pnsn/mcsoh/images/2-IMG_2275.JPG

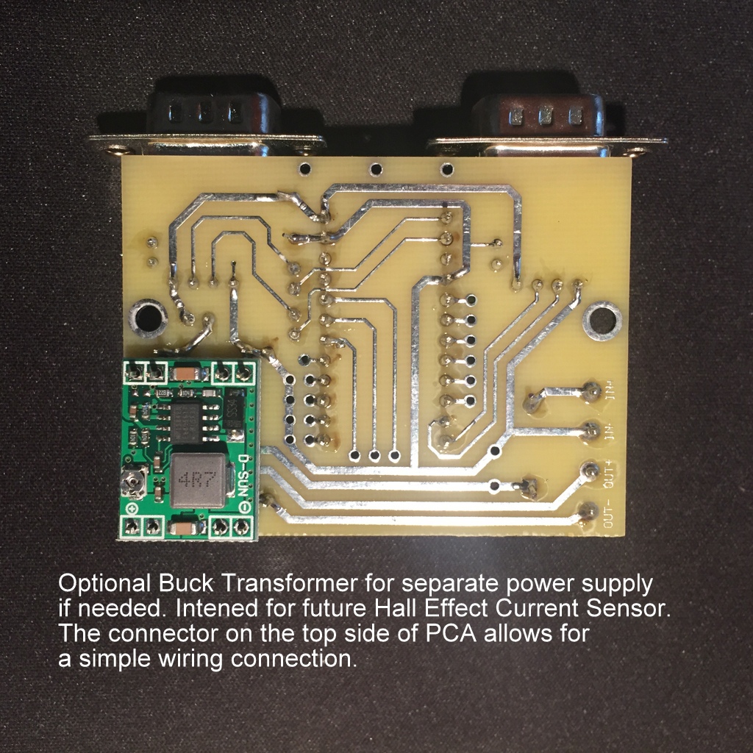
images/2-IMG_2275.JPG
