pnsn/mcsoh/images/1-IMG_2274.JPG

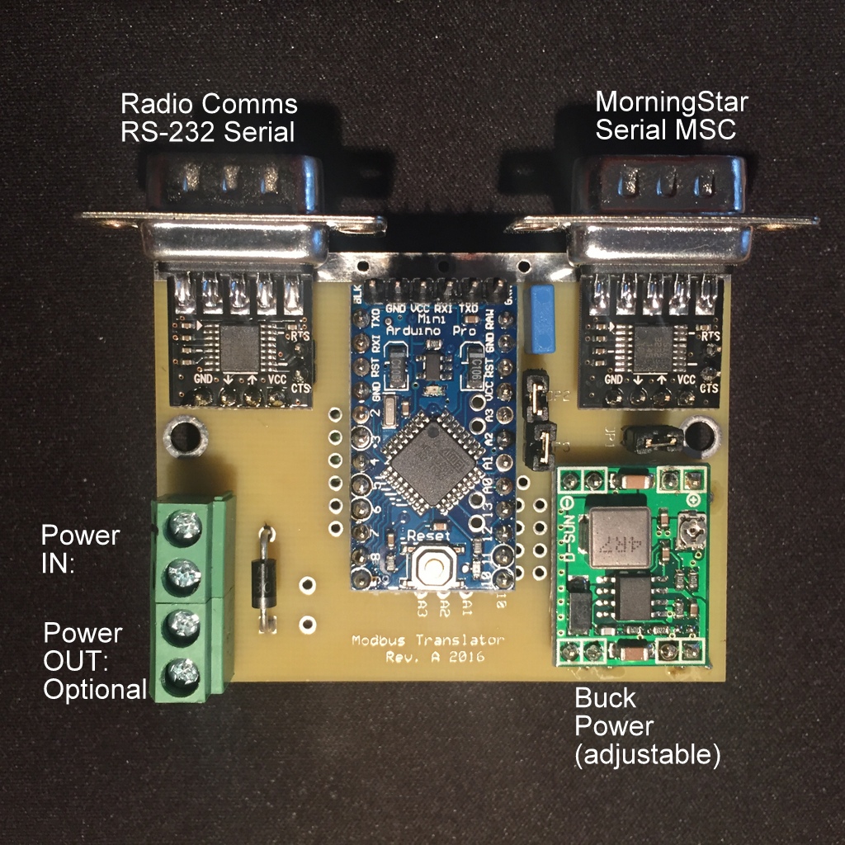
images/1-IMG_2274.JPG
