pnsn/mcsoh/tools/README.md

#tools directory: place to keep and utilities or tools for reflashing, testing, fixing etc...
i.e. AVRDude tool for reflashing Arduino microcontrollers.
