pnsn/mcsoh/docs/Params2.docx

The company

MODBUS Translator

Message Specification

Marc Biundo

| SunSaver MPPT Message Layout
ModBus Logical Addr | Item name | Item description | Units | Scaling / Range / Example Data
- | Message ID | $PMPPTDAT | - | -
- | FW Version | Firmware Version | | 1.0.0
9 | Adc_vb_f | Battery voltage, filtered (τ ≈ 1s) | V | n·100·2⁻¹⁵
10 | Adc_va_f | Array voltage, filtered (τ ≈ 1s) | V | n·100·2⁻¹⁵
11 | Adc_vl_f | Load voltage, filtered (τ ≈ 1s) | V | n·100·2⁻¹⁵
12 | Adc_ic_f | Charging current, filtered (τ ≈ 1s) | A | n·79.16·2⁻¹⁵
13 | Adc_il_f | Load current, filtered (τ ≈ 1s) | A | n·79.16·2⁻¹⁵
14 | T_hs | Heatsink temperature | ºC | -127 to+127
15 | T_batt | Battery temperature (Either ambient or RTS if connected) | ºC | -127 to+127
16 | T_amb | Ambient temperature | ºC | -127 to+127
17 | T_rts | Remote battery temperature sensor (0x80 if not connected) | ºC | -127 to+127
18 | charge_state | Charge state - | -
19 | array_fault | Array fault bit field - | -
20 | Vb_f | Battery voltage, slow filter (τ ≈ 25s) | V | n·100·2⁻¹⁵
21 | Vb_ref | Battery regulator reference voltage | V | n·96.667·2⁻¹⁵
22 | Ahc_r_HI | Ah charge resettable, HI word | Ah | n·0.1
23 | Ahc_r_LO | Ah charge resettable, LO word - | -
24 | Ahc_t_HI | Ah charge total, HI word | Ah | n·0.1
25 | Ahc_t_LO | Ah charge total, LO word - | -
26 | kWhc | KWh charge (resettable?) | kWh | n·0.1
27 | load_state | Load state - | -
28 | load_fault | Load fault bit field - | -
29 | V_lvd | load current compensated LVD voltage | V | n·100·2⁻¹⁵
30 | Ahl_r_HI | Ah load resettable, HI word | Ah | n·0.1
31 | Ahl_r_LO | Ah load resettable, LO word - | -
32 | Ahl_t_HI | Ah load total, HI word | Ah | n·0.1
33 | Ahl_t_LO | Ah load total, LO word - | -
34 | hourmeter_HI | hour meter, HI word | h | 0 to (2²⁴-1)
35 | hourmeter_LO | hour meter, LO word - | -
36 | alarm_HI | alarm bit field – HI word - | -
37 | alarm_LO | alarm bit field – LO word - | -
38 | dip_switch | dip switch settings at power on switch[1..8] in bits[0..7]- | -
39 | led_state | SOC LED state - | -
40 | Power_out | Charge output power | W | n·989.5·2⁻¹⁶
41 | Sweep_Vmp | Array Vmp found during sweep | V | n·100·2⁻¹⁵
42 | Sweep_Pmax | Arrap Pmax(output) found during sweep | W | n·989.5·2⁻¹⁶
43 | Sweep_Voc | Array Voc found during sweep | V | n·100·2⁻¹⁵
44 | Vb_min_daily | Vb minimum voltage – daily | V | n·100·2⁻¹⁵
45 | Vb_max_daily | Vb maximum voltage – daily | V | n·100·2⁻¹⁵
46 | Ahc_daily | Ah charge - daily | Ah | n·0.1
47 | Ahl_daily | Ah load - daily | Ah | n·0.1
48 | array_fault_daily | Array fault bit field - daily - | -
49 | load_fault_daily | Load fault bit field - daily - | -
50 | alarm_HI_daily | alarm bit field – daily, HI word - | -
51 | alarm_LO_daily | alarm bit field – daily, LO word - | -
52 | vb_min | minimum battery voltage | V | n·100·2⁻¹⁵
53 | vb_max | maximum battery voltage | V | n·100·2⁻¹⁵
- | Checksum | *hh | - | 00 - FF
- | EOM | <CR><LF> (End of message termination) | -

Modeled after NEMA 0183 specification. A simple ASCII serial communication protocol that define how data are transmitted in a “sentence” from the ‘talker’ to the ‘listener’.

Protocol rules:

- Each message's starting character is a dollar sign.
- The next eight characters identify the talker (5 characters) and the type of message (3 characters).
- All data fields that follow are comma-delimited.
- Where data is unavailable, the corresponding field remains blank (it contains no character before the next delimiter.
- The first character that immediately follows the last data field character is an asterisk, but it is only included if a checksum is supplied.
- The asterisk is immediately followed by a checksum represented as a two-digit hexadecimal number. The checksum is the bitwise exclusive OR of ASCII codes of all characters between the $ and *. According to the official specification, the checksum is optional for most data sentences, but is compulsory for RMA, RMB, and RMC (among others).
- <CR><LF> ends the message.

Each item adheres to Modbus rules; that is, they are 16-bit raw values that need to be scaled as indicated in the above table.

SunSaver MPPT Logged Data Layout
Item name | Item description | Units | Scaling / Range / Example Data
Message ID | $PMPPTLOG | - | -
Hourmeter | 24 bit value ‘hour meter’ timestamp | h | 0 to (2²⁴-1)
Alarm_daily | 24 bit Alarm bit field – daily | - | -
Vb_min_daily | Vb minimum voltage – daily | V | n·100·2⁻¹⁵
Vb_max_daily | Vb maximum voltage - daily | V | n·100·2⁻¹⁵
Ahc_daily | Ah charge - daily | Ah | n·0.1
Ahl_daily | Ah load - daily | Ah | n·0.1
Array_fault_daily | Array fault bit field – daily | - | -
Load_fault_daily | Load fault bit field – daily | - | -
Va_max_daily | Va maximum voltage – daily | V | n·100·2⁻¹⁵
Time_ab_daily | Time in absorption - daily | min | -
Time_eq_daily | Time in equalize - daily | min | -
Time_fl_daily | Time in float – daily | min | -
- | Reserved | - | -
- | Reserved | - | -
- | Reserved | - | -
Checksum | *hh | - | 00 - FF
EOM | <CR><LF> (End of message termination) | -

Logged Data

The SS-MPPT stores approximately 32 days of data. This data is stored in a circular buffer where the oldest data is over-written by the newest data. The log data must be requested and sorted into correct order before the data will be useful.

- The logged data is mapped from 0x8000-0x81FF (1kB)
- The data consists of up to 32 blocks of data. (One block is generally one day w/ some exceptions)
- Each block is 32bytes (16 modbus variables)
- It is written in a circular buffer format. All blocks must be read and then put in linear order via the hourmeter field. Ignore blocks w/ hourmeters of 0x000000 or 0xFFFFFF. The largest hourmeter block is the most recent.

Data is stored in big endian format.

struct { Uint24 hourmeter;

Uint24 alarm_daily;

Uint16 Vb_min_daily;

Uint16 Vb_max_daily;

Uint16 Ahc_daily;

Uint16 Ahl_daily;

Uint16 array_fault_daily;

Uint16 load_fault_daily;

Uint16 Va_max_daily;

Uint16 time_ab_daily; v0.7 code and later

Uint16 time_eq_daily; v0.7 code and later

Uint16 time_fl_daily; v0.7 code and later

Uint16 reserved[3];

}

Data Retrieval Commands

In order to make the retrieval of data controllable there are three methods for the translator to send messages.

1. ‘t’ - Periodic method. Message string will be sent at a timed interval (every 5 seconds for instance).
2. ‘r’ - Command based method. Send messages upon command from the receiver. Periodic method disabled.
3. ‘l’ - Command based Logged Data method. Shuts down status messages and sends one log entry per command. The status messages are disable until either of the above commands are sent.

The logged data is retrieved using the ‘l’ (logged) command. Each command cause one entry of the MPPT log circular buffer to be read and sent out. Each entry has a ‘hourmeter’ time stamp. After all the entries have been retrieved (32) they need to be sorted by the ‘hourmeter’ field. This is also the way you can tell if all the entries have been received. The status messages are disabled so as not to mix up the receiver on what data is being received.

After getting the logged data, the status messages can be turn back on by either sending the ‘t’ command causing the messages to be sent on a time interval or the ‘r’ command that will get one status message only.
