pnsn/mcsoh/Battery Spec Sheets/AirCells-2 AS10-2_en.pdf

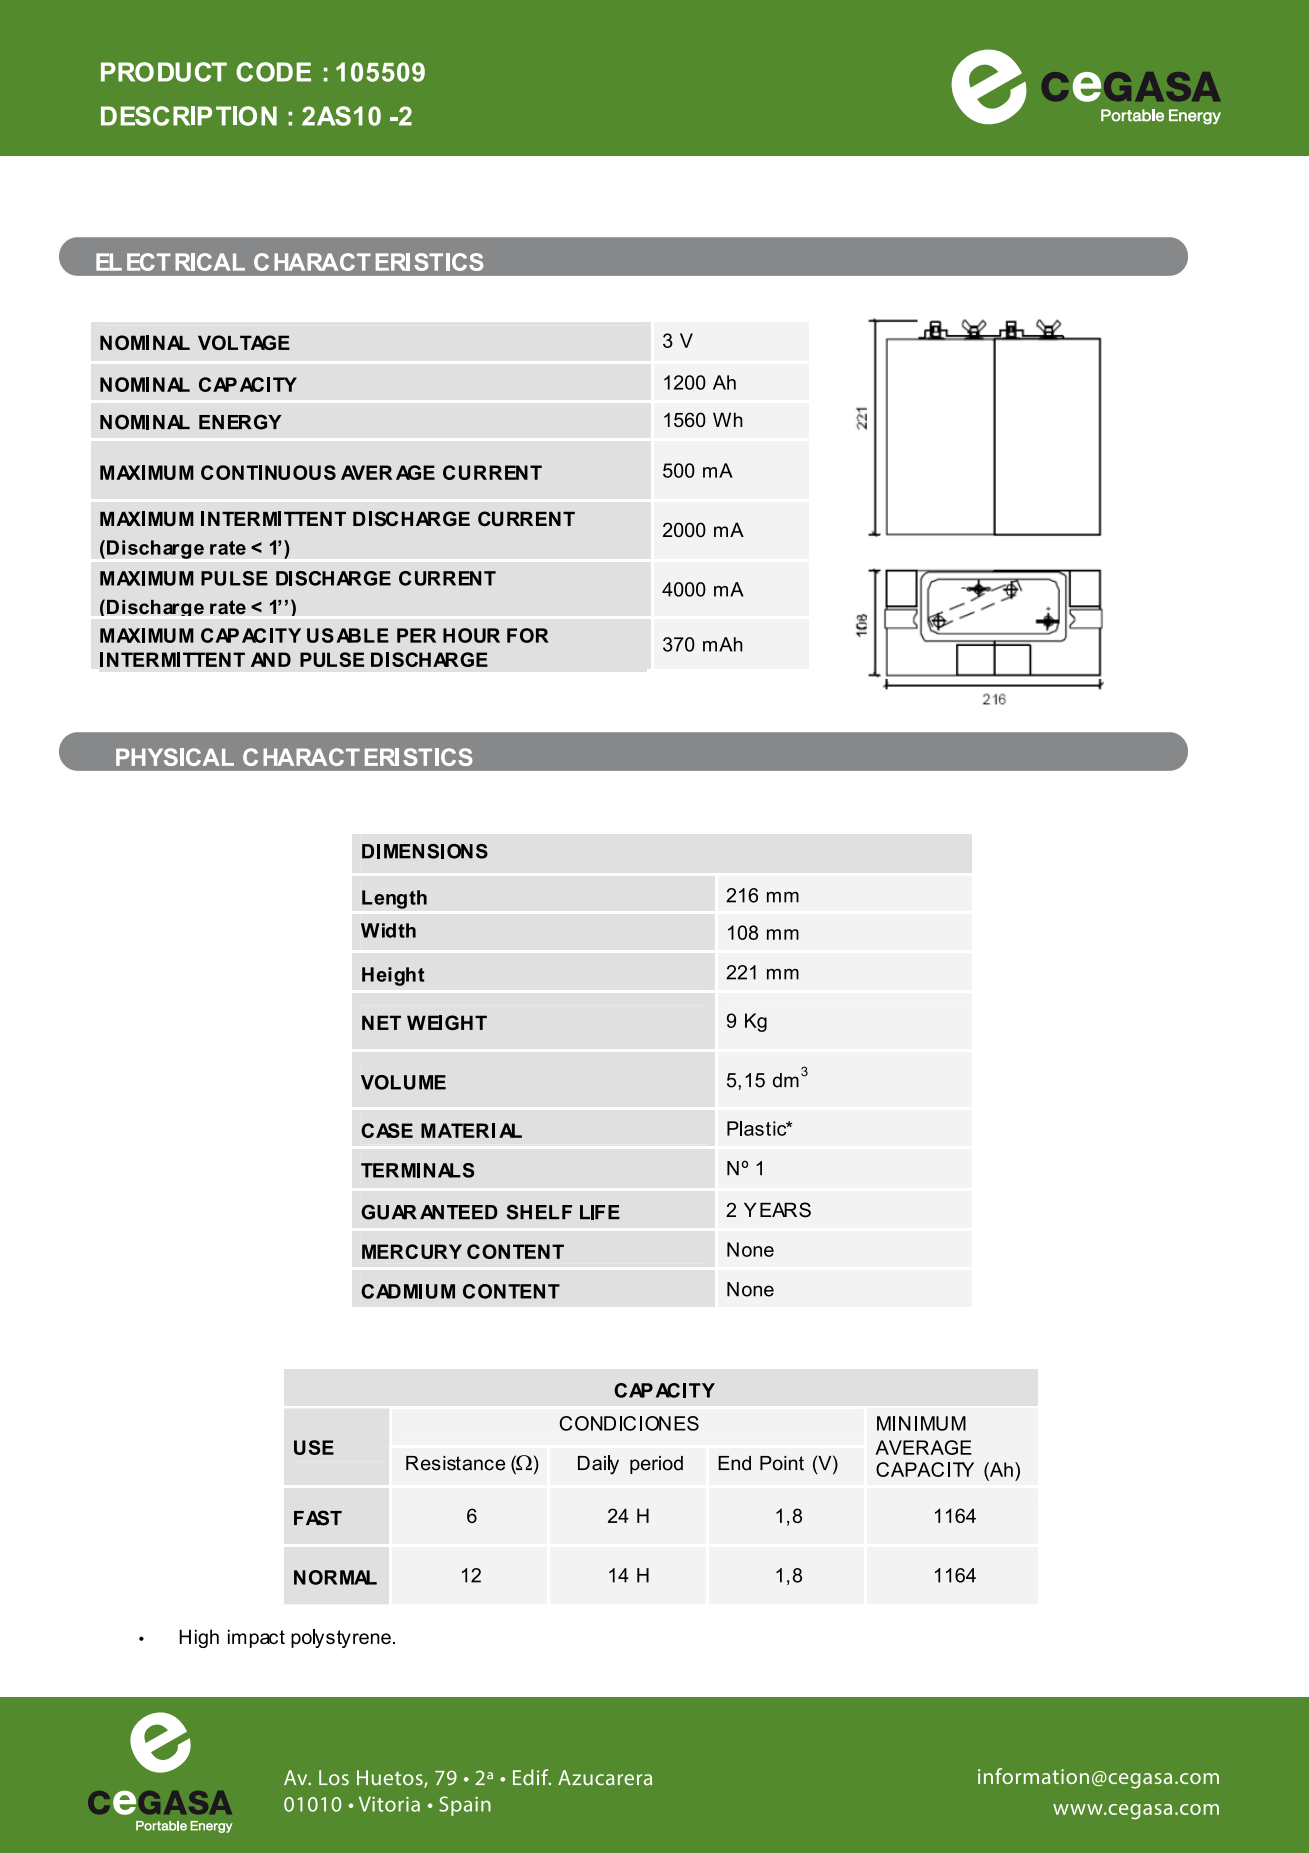
[picture p7: page 1]

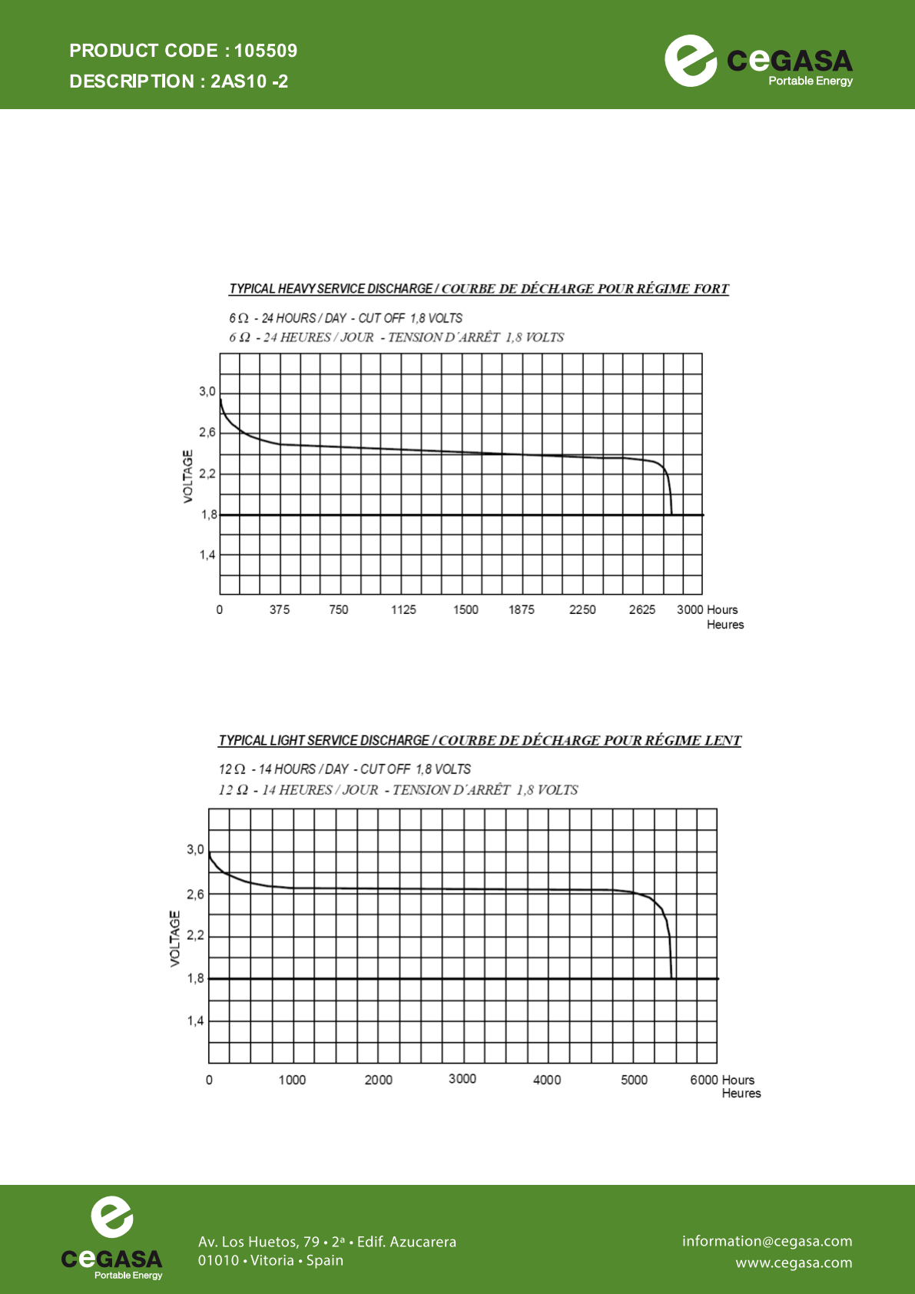
[picture p8: page 2]
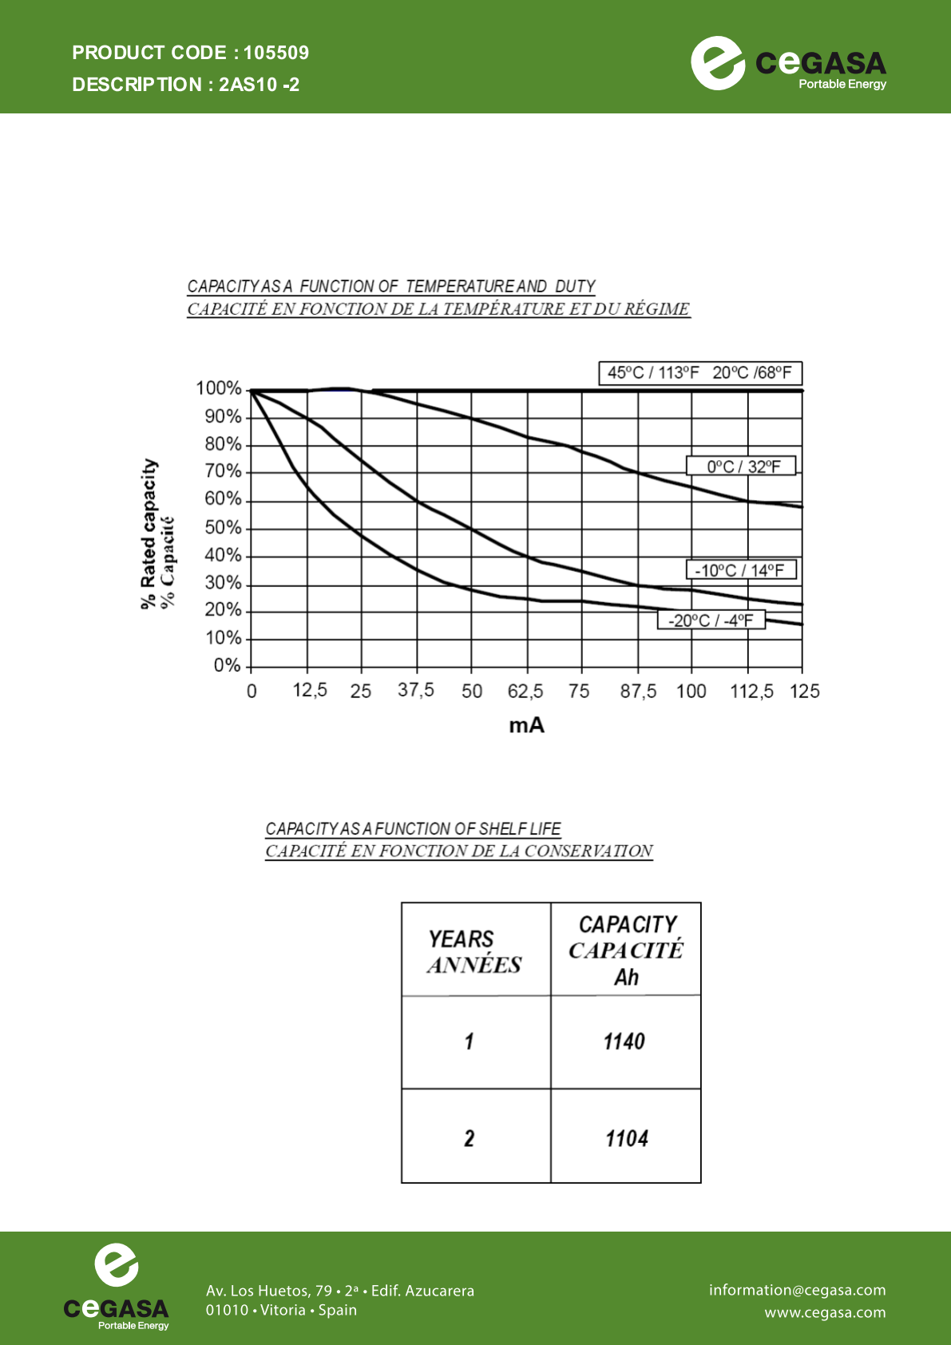
[picture p9: page 3]
