pnsn/mcsoh/Battery Spec Sheets/Battery LA AGM DURA12-35C.pdf

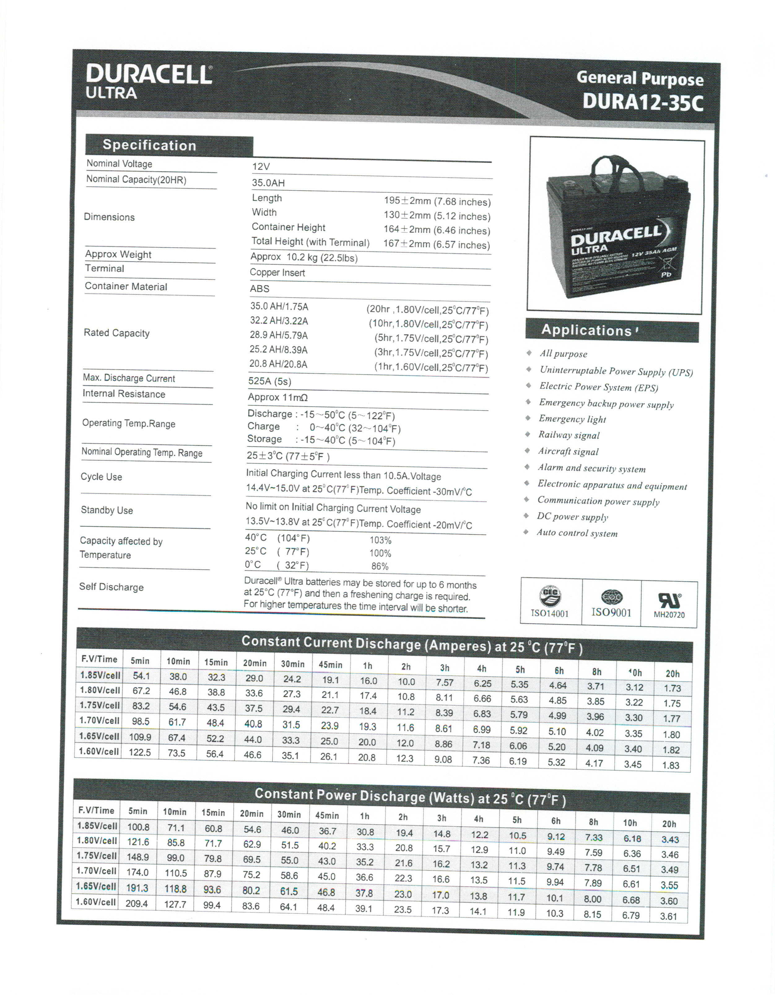
[picture p10: page 1]
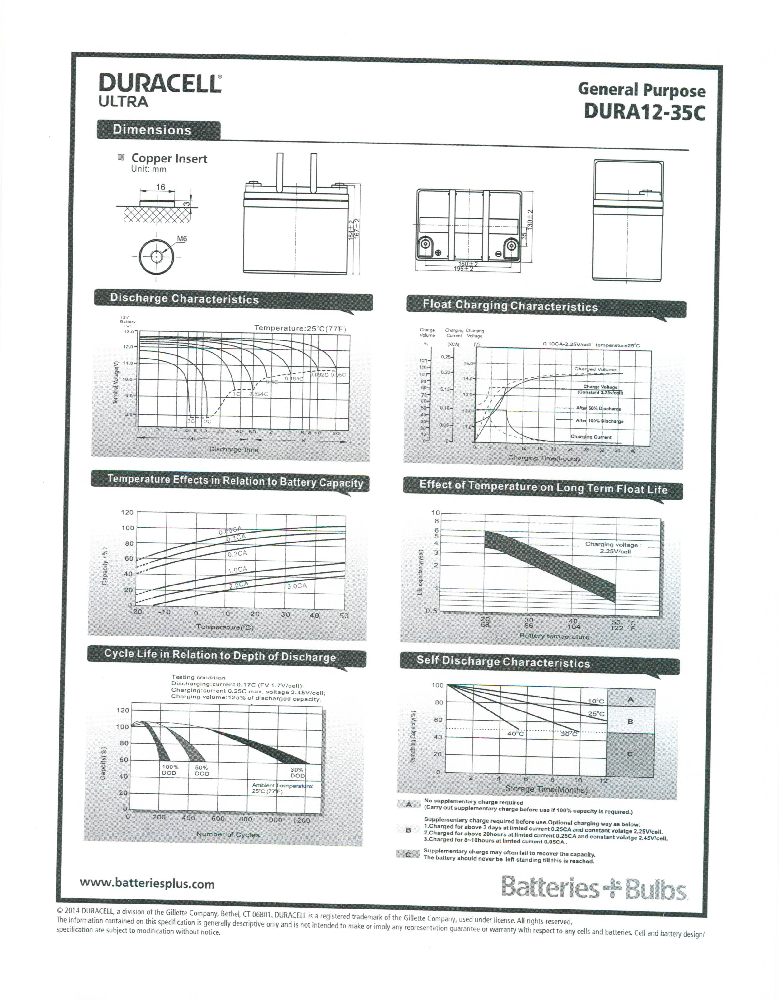
[picture p11: page 2]
