pnsn/mcsoh/ExpressPCB/Modbus Translator MiniBrd RevEXP1.bmp

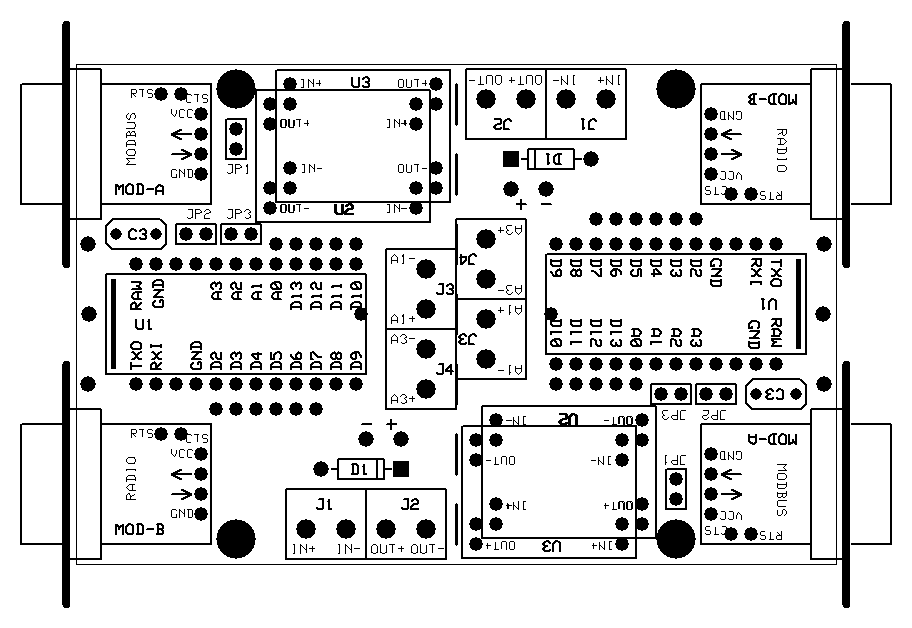
ExpressPCB/Modbus Translator MiniBrd RevEXP1.bmp
