pnsn/mcsoh/images/3-IMG_2276.JPG

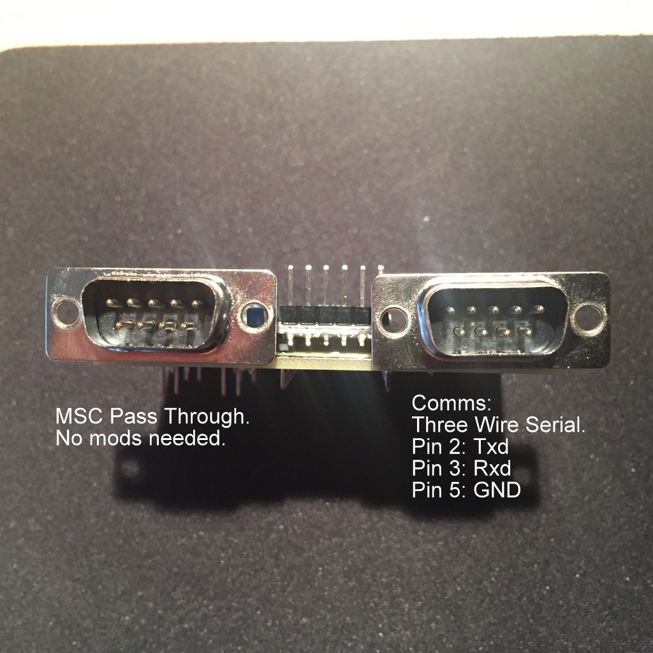
images/3-IMG_2276.JPG
