pnsn/mcsoh/images/4-IMG_2277.JPG

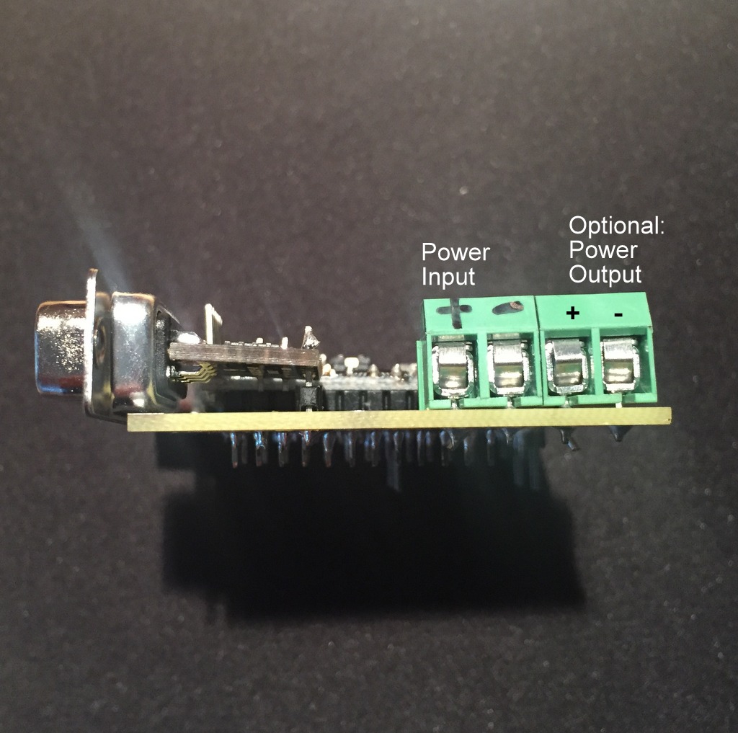
images/4-IMG_2277.JPG
