pnsn/mcsoh/images/5-IMG_2279.JPG

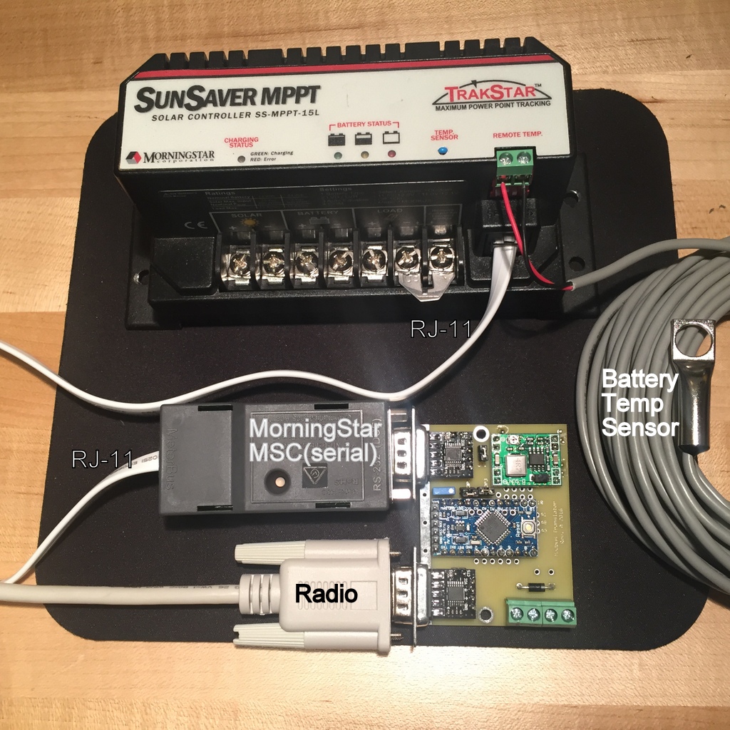
images/5-IMG_2279.JPG
