pnsn/mcsoh/images/6-IMG_2280.JPG

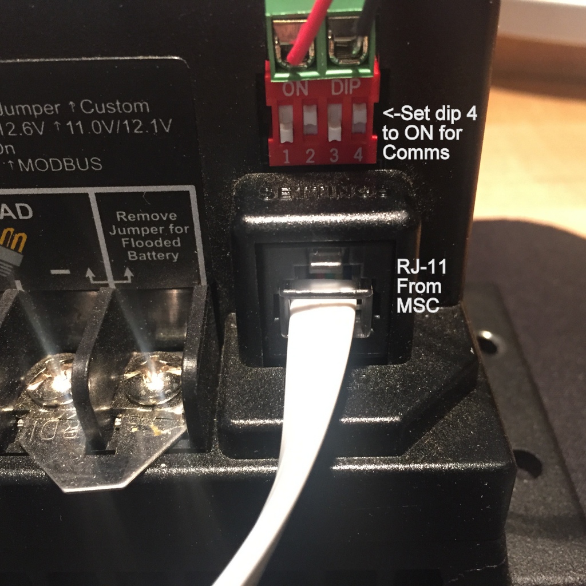
images/6-IMG_2280.JPG
