pnsn/mcsoh/images/7-IMG_2281.JPG

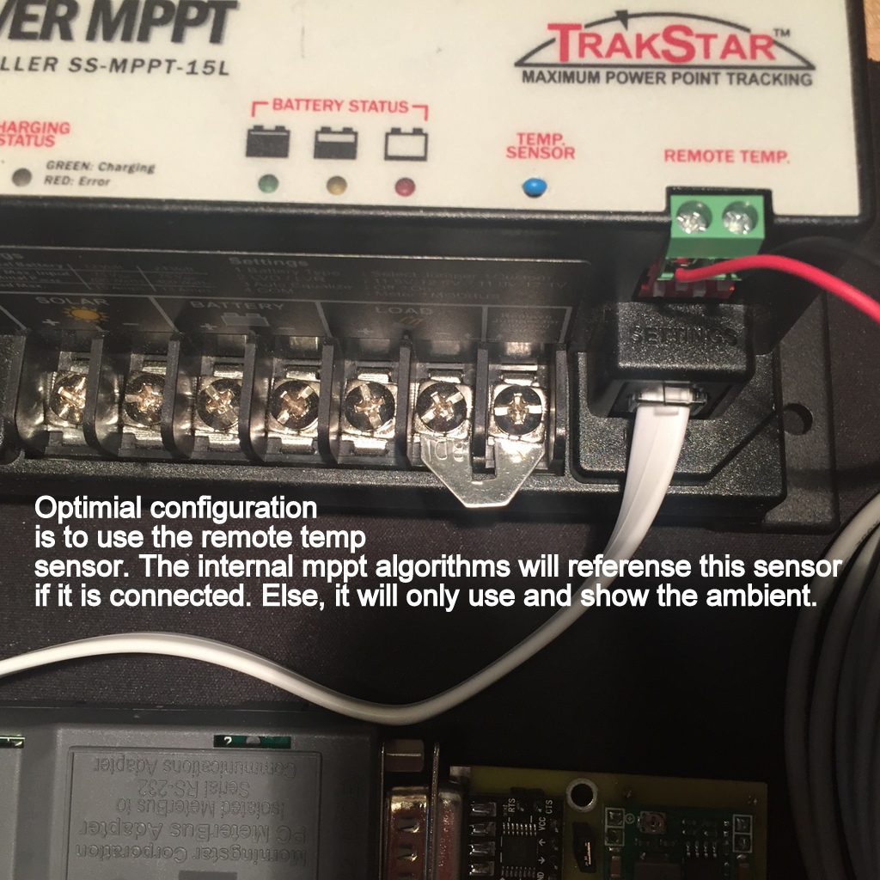
images/7-IMG_2281.JPG
