pnsn/mcsoh/PortSettings/ES450Cell_ModemSerialPortSettings.JPG

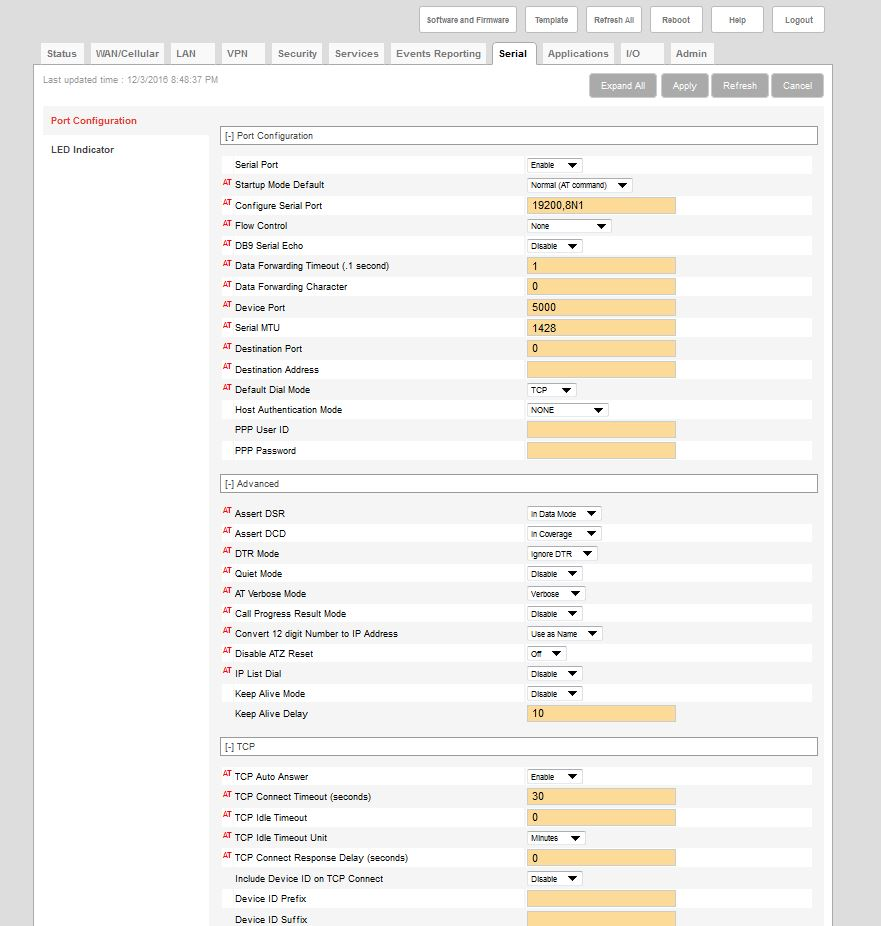
PortSettings/ES450Cell_ModemSerialPortSettings.JPG
