pnsn/mcsoh/PortSettings/FreewaveSerialPortSettings.JPG

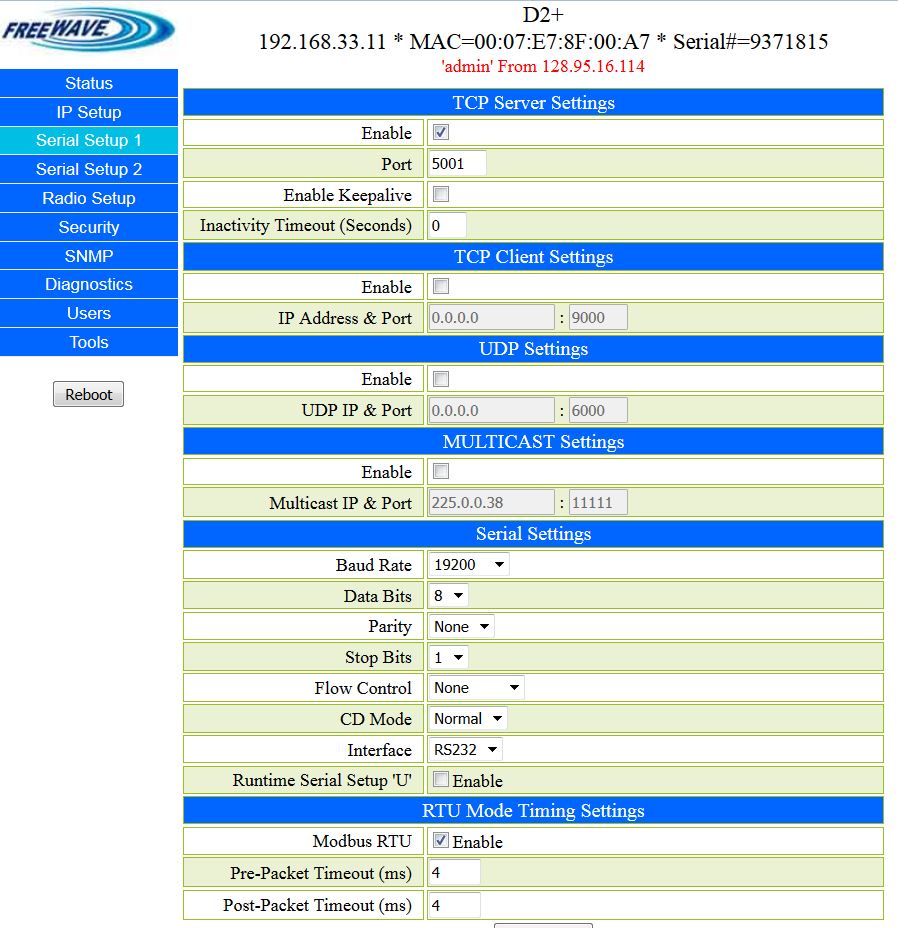
PortSettings/FreewaveSerialPortSettings.JPG
