pnsn/mcsoh/PortSettings/LocalPCSerialSettings.JPG

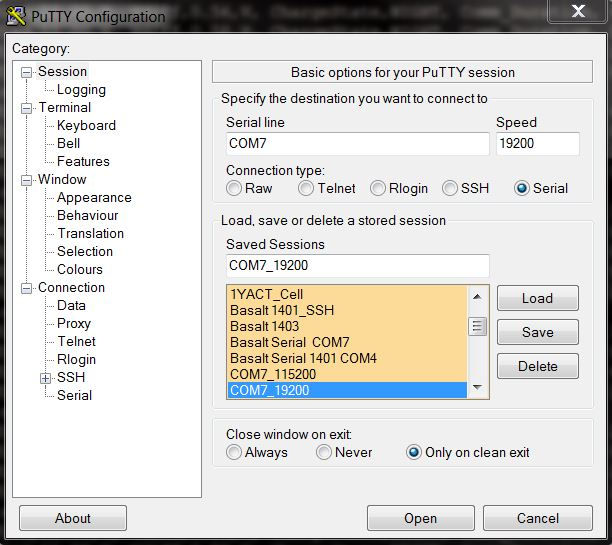
PortSettings/LocalPCSerialSettings.JPG
