pnsn/mcsoh/PortSettings/RemotePuttySettings.JPG

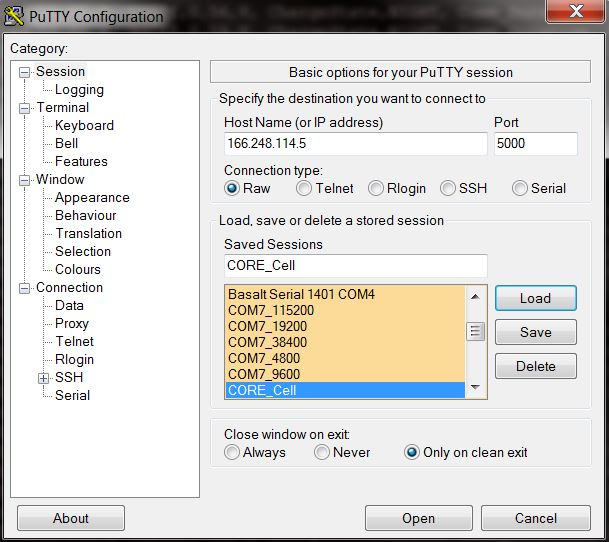
PortSettings/RemotePuttySettings.JPG
