pnsn/mcsoh/PortSettings/XetawaveSerialPortSettings.JPG

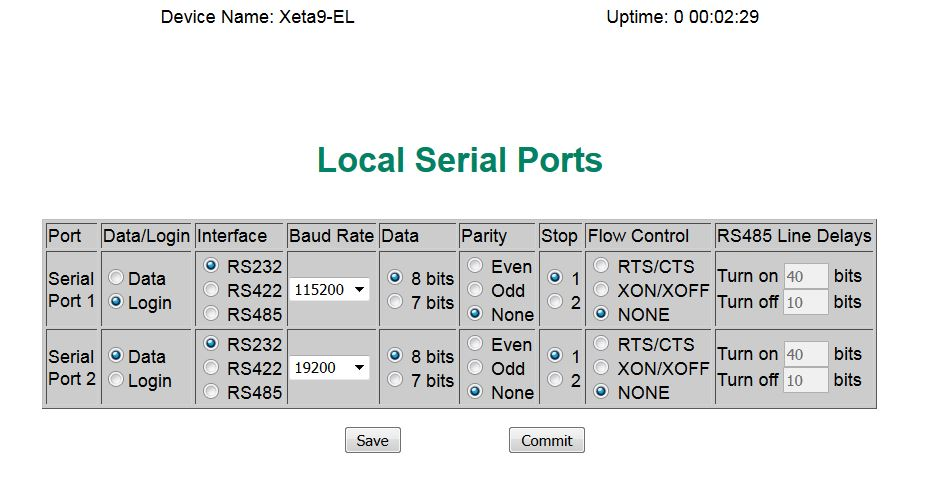
PortSettings/XetawaveSerialPortSettings.JPG
