pnsn/mcsoh/schematics_drawings/ArduinoProMini.bmp

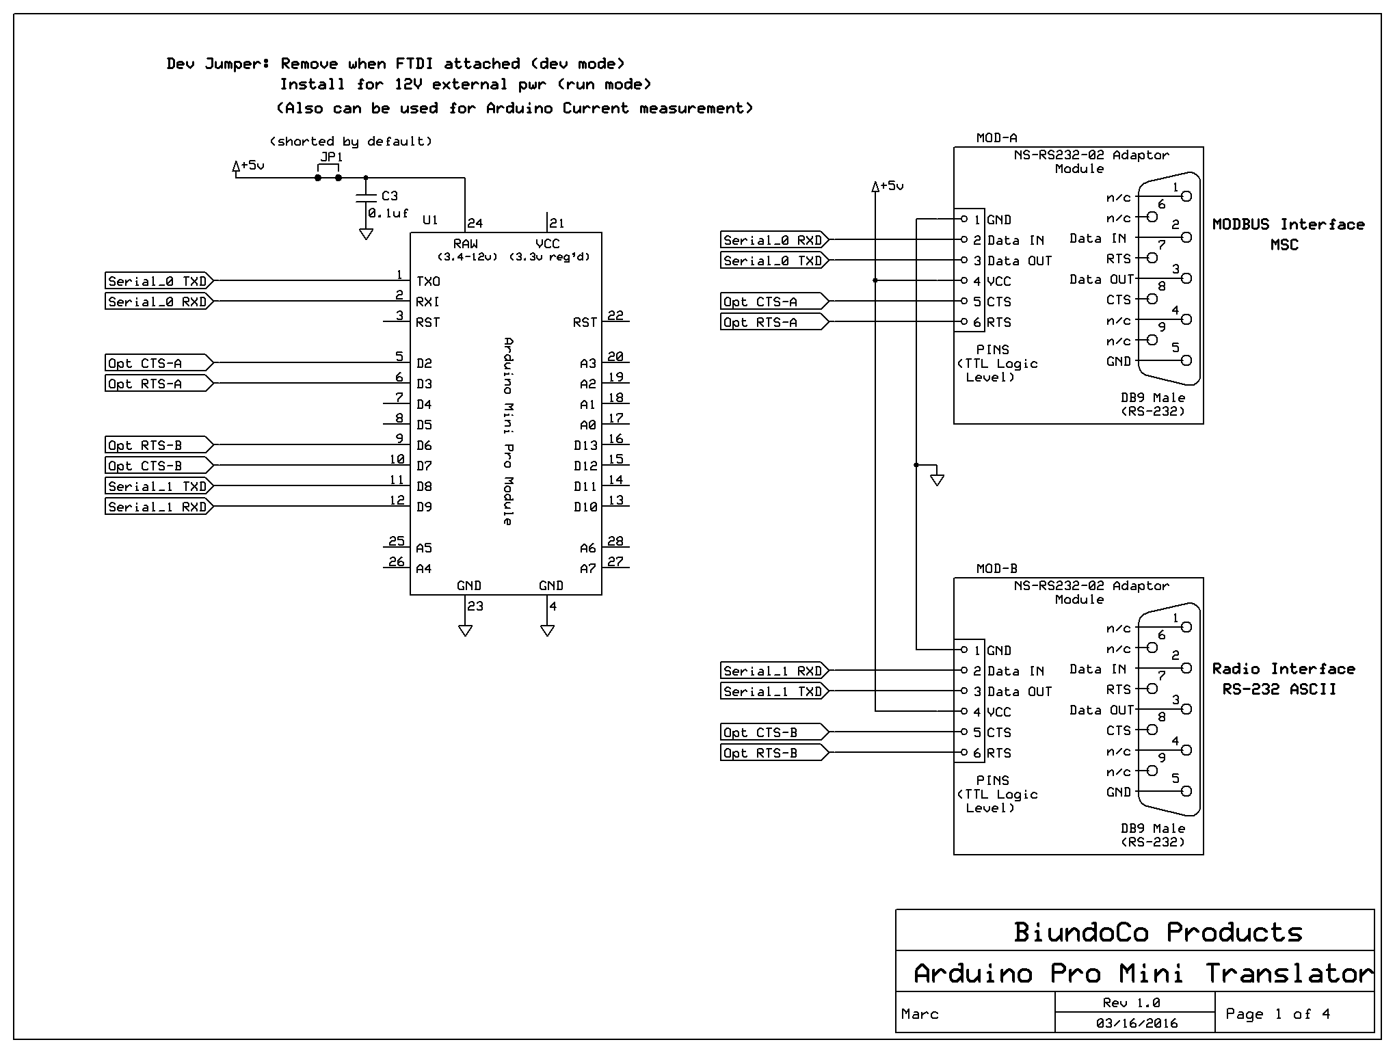
schematics_drawings/ArduinoProMini.bmp
