pnsn/mcsoh/schematics_drawings/BuckPowerSupply.bmp

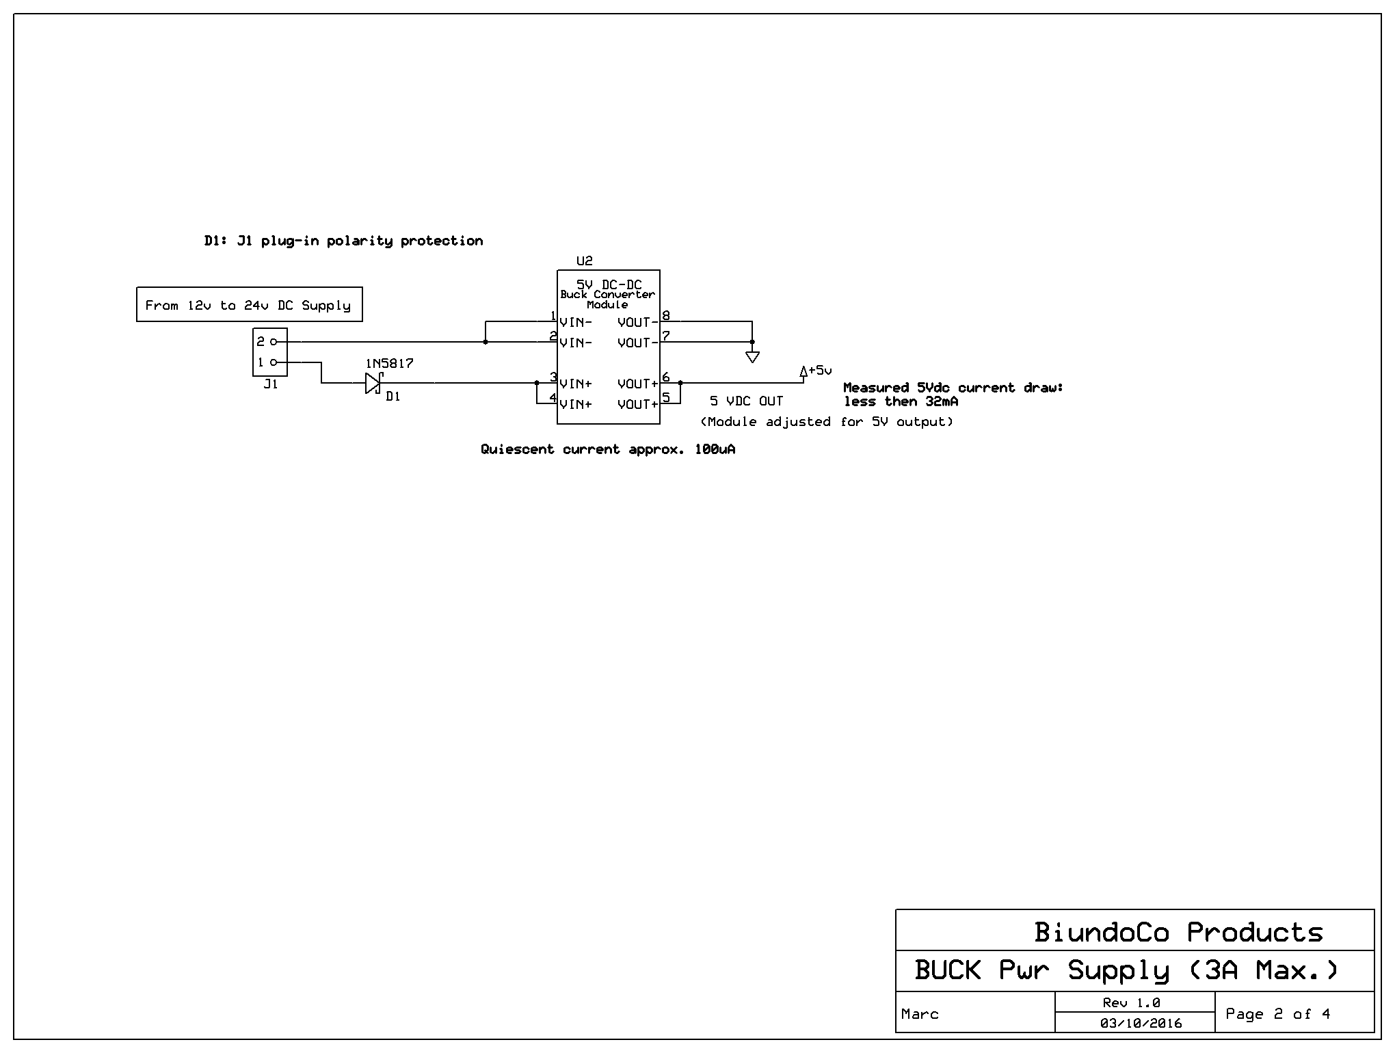
schematics_drawings/BuckPowerSupply.bmp
