pnsn/mcsoh/docs/RevB Translator BOM.xlsx

Qty | ID | Description | Vendor / Part number | Comments
1 | C3 | 0.1uf (100nf) bypass | Various | .2" lead spacing
1 | D1 | 1N5817 Schottky Diode | Digikey 1N5817DICT-ND | Found on Amazon
2 | J1, J2 | 2-Pin Screw Terminal Block | Amazon Gikfun 5.08-301-2P | Found on Amazon
2 | MOD-A, MOD-B | RS232 Converter | NULSOM NS-RS232-02 | Found on Amazon
1 | U1 | Arduino Pro Mini 328 | Sparkfun DEV-11113 | Found on Amazon
2 | U2, U3 | MP1584EN Buck Converter | Amazon Qunqi MP1584EN | Found on Amazon
13 | see comments | 2-Pin Header strip | Various | JP1-3, Buck converters, RS232 converters
2 | MOD-A, MOD-B | 4-Pin header strip | Various | used for RS232 Converters, MODA-B
1 | U1 | 6-Pin header strip | Various | used for Arduino Pro Mini, U1
2 | U1 | 12-pin header strip | Various | used for Arduino Pro Mini, U1
3 | JP1,JP2,JP3 | 2-Pin shorting Blocks | Various | used for JP1-3 Found on Amazon
1 | Box | Comando Green Survivor Box | Amazon / MTM Case-Guard | Found on Amazon
1 | MSC | MorningStar Serial MSC 1 | ECO Distributing LLC
1 | MS-RTS | MorningStar Remote Temp Sense | ECO Distributing LLC | Proto-typing home brew… much cheaper!
2 | RJ-11 | RJ-11 connector | Various | MPPT to MSC connection
1 | RS-232 Male | Radio Side/msc Connection | Various | Found on Amazon
1 | RS-232 Female | Arduino Serial Side Connection | Various | Found on Amazon
2 |  | 40-pin header strip | Various | will need 64 of the 80 pins…
 | 12+12+6+4+4 | 38 pins of one strip
 | 2 * 13 | 26 pins of other stip
