pnsn/mcsoh/(threads)

Thread 1 (2016-10-09):

rrdtool Charge State gaps in graphs

mbiundo, 2016-10-09:
You will notice the Charge State Graphs have gaps in them at random intervals.... This is "not really" an issues. Just ugly. It's a by product of the Reverse Polish Notation code needed to make the state chart work. The RRDTool step size is averaging the values. The RPN code in the chart wants discrete values, 1,2,3.... to graph each state. When the mppt state machine changes from 1, 2.... if this falls within the RRD tool step size, 1,1,1,1,2,2,2,2 probably looks like this in the database 1,1,1,1.5,2,2,2,.... The graph will only chart an int not a real number, so it defaults to 0 and you get no state.... You can see it in the chart if you look at "Last" when you are in this mode..... Manipulating the step size of the RRD may help... Low priority...

mbiundo, 2016-10-09:
Here is an example.... There will be caps if there is a periodic gap issue. Reference the Current graph to differentiate between an actual data gap.
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

mbiundo, 2016-10-09:
closed it by accident;)

Thread 2 (2016-10-09):

Periodic Gaps in all data

mbiundo, 2016-10-09:
When looking at stable stations you can see a consistent periodic you can see it across all stations if you look closely. Is there an issue with the "Insert.py" code? Or is it an issue with the web3 box or code running. Look at graph for review... Every three days or so.

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

Thread 3 (2016-10-09):

Analog Inputs

mbiundo, 2016-10-09:
Four spare Analog inputs are available on the Arduino. Marc will look at updating:
1. The pca to make it simple to add these inputs.
2. devise a standard voltage zero / interval to accept different hardware / sensors.
3. Provide a spare power supply on the PCA, DONE. Mapped into silk screen, but you have to mount it on the bottom.
4. Update the NEMA message for "Spares" and Inserts into the RRD for spares.
5. The RRD tool provides a method to add new DS's on the fly.... But make sure they get added to the DB creation scripts!

mbiundo, 2016-11-07:
Rev B PCB's have the 2 Analog inputs A1 and A3 available via a screw terminal blocks... All Analog inputs and digital I/O can be accessed by adding an pin strip next to the Arduino.... We may be able to devise a daughter board to leverage them too...

Thread 4 (2016-11-13):

Serial Comm Port

mbiundo, 2016-11-13:
there are two types of serial hardware. The female and mail type. The male is pass through.. So pin 2=2 and 3=3...The female type will require pins 2 and 3 to be swapped. On the radio / cell side make sure to jumper pins 1,4 and 6 together... Cell modems will not work if you do not... It's a requirement from the RS-232 spec.

Thread 5 (2016-12-11):

AC Delco S2000 Power Supply Tweak

mbiundo, 2016-12-11:
For AC Fed systems (Class 2 MeanWell Power Supply acting as Solar Panel)... We typically use a 100AHr AC Delco S2000 Sealed Battery. The power supply will need to be turned up from 15V output to it's max. About 17.45 Volts. If you do not, the MPPT controller will stay in the BULK State. For long a duration, this is probably not good for maximum life of the battery. If you increase the output of the power supply, the MPPT will account for this and act as designed, BULK->Absorption->Float... So please adjust the power supply to 17.45 V. See power supply spec sheet for correct potentiometer to turn.
Changing Power Supply Output:
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
Yields correct state machine output of mppt.
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
The charge current did not change.
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

mbiundo, 2017-04-17:
We have decided to modify the design. We will now use a 24V supply.
By making this change we:
1. Ensure the charging potential can transition through Bulk, Absorb and Float effectivly for any battery type.
2. Remove the manufacturing step of having to open the power supply and raise the Output voltage.
-Marc

Thread 7 (2017-01-16):

Battery Backup Example

mbiundo, 2017-01-16:
Folks,
To close on this topic... I did a test to demonstrate a discharge curve of an simulated EEW station while holding a few parameters constant. In summary, we should have enough margin to meet the 4 day backup power criteria for EEW sites if we use a 100A hour capacity battery.  I recommend a 100A hr S2000 Lead Acid battery as  a backup battery for all future EEW sites.

This test yielded a "Backup power on time" of approximately 4.5 days.

Paul, this is the design you and I installed at CHZZ (Cape Mearse OR)

If you have any questions or want to talk, please drop me a line.

Test Parameters held constant:
Battery: 100 A Hr S2000 Sealed Lead Acid
Temperature: Ambient ~25C
Load: 0.5 Amp constant Load( Light Bulb) to emulate Sensor and Radio...
New Power Panel Design with Mppt Solar controller and Class 2 DC power supply.

Batteries Age, performance falls off, and have a life span dependent on stress and cycle times...
--Marc
Data:

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

Marc Biundo <mbiundo@uw.edu>

Jan 9 (6 days ago)

Thread 8 (2017-04-17):

24V DC Input Verification

mbiundo, 2017-04-17:
This is a test to demonstrate using a CLASS 2 24 Volt DC supply instead of a 15V DC Supply. In summary, the Morningstar Solar Controller senses the Battery potential and adjusts the output to the load accordingly. So you can place a 15V, 20V, 24V, 48V supply on the Solar Input and the controller will adjust the V batt for a 12V battery. Please do not stack the batteries in series as you may run the risk of providing an overvoltage to the input of the load. It is advised that you read the datasheet for any load you connect to make sure the input voltage to them is not exceed. Else, you will destroy them.
-Marc
Images below show a 24V supply powering our system with the Morningstar MPPT controller. The battery type is a 12V Sealed 100aHr Delco s2000.

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
