pnsn/mcsoh/(list of files, drawings)

Other design files:
ExpressPCB/Modbus Translator MiniBrd RevEXP1.pcb
