pnsn/mcsoh/(commit log)

2016-08-23 Replaced MARC station with CORE station... Need insert MARC down below.
2016-09-05 Hardware Schematics and Images
    These images will help someone that may want to build a few. The BOM xlsx is the Bill OF Materials for the parts.
    [Translator BOM.xlsx]
2016-09-25 schematics and drawing folder creation
    For hardware and PCA's....
2016-09-26 mv schmatics into schematics directory
2016-09-26 moved documents to docs directory
    [Translator BOM.xlsx]
2016-10-02 Pulling in images and docs to master.
    [Translator BOM.xlsx]
2016-10-02 changed battery temp color to green from blue
2016-10-02 changed battery temp line types from 1 to 2, thiker for easy reading.
2016-10-02 test: RRDGraph vbatt-lvd, trying to add average trace to plot.
2016-10-02 AVRDude utility README pdf for reflashing Arduino
2016-10-02 Add files via upload
    Two types of Hall Sensors for measuring current through a conductor.
2016-10-16 RevB Translator BOM
    Added room on PCA for 2 pin screw terminals so Analog inputs 1 and 3 could be easily connected with a wire...
    Lists all vendors and parts. Found most on Amazon.
    [RevB Translator BOM.xlsx]
2016-10-16 Schmatics and Printed Circuit Board Files
2016-10-16 RevB PCB Files
    Two up PCB file to save costs. Board must be cut. Added Room for A1 and A3 analog inputs via screw terminal headers.
    [Modbus Translator MiniBrd RevEXP1.pcb, Modbus Translator RevEXP1.sch]
2016-10-21 Made Charge State a Diverging Stacked Bar Chart. Made autoscale --rigid and cleaned up comments for easy reading.
2016-10-23 Corrected pin out
    RS-232 Rx and Tx need to be swapped for Radio/Cell comms.. DONT FORGET or you will need a null connector.
    [Modbus Translator RevEXP1.sch]
2016-10-24 Add cmgraph.sh. A script to create monthlong multi station charge state graphs
2016-10-24 updated make_images.sh to call cmgraph.sh for each station. The goal is to give a 2month charge state overview
2016-10-25 Added TEST unit into end of web page. Want to validate AC powered system.
2016-10-31 Three Stage Battery Charging Document
    A basic explanation how a three stage battery charger works... Some basic chemistry and electronics too.
2016-11-06 added the sta name on the right axis of the charge state graphs.
2016-11-07 Removed CablesMCSOH.bmp. Please reference update in ExpressPCB directory.
2016-11-12 Power Supply and Arduino Pro Mini Schematics
2016-11-12 Serial board chip datasheet
2016-11-14 NulSoft Serial Boards for MCSOH
2016-11-27 Added a shaded area at 11.4v and down to express non-linear area of low battery.
2016-12-04 Create systemd.rd
    We switched from cycling the insert.py with cron... To making insert.py a infinite while loop. It is managed with systemd.
2016-12-04 Serial Port Settings from Putty Remotely
    Before you enable the StationList.txt call from insert.py, use putty to make sure you can connect from Putty... It uses the RAW.
    -Marc
2016-12-08 Added test station to validate AC powered system SOH.
2017-04-12 added TEST to index.html for 24V PS testing.
2017-12-11 Made string handeling fixes for incorect data frame parsing.
2018-06-11 tweaked insert.py to fix bug, removed BROK, MARC and TEST from Index.html.
2018-06-20 Added try in insert.py around line 662 to catch error. Seemed to help.
2018-09-04 Create De-Couple Capacitor
    Link to a good article for adding the decoupling cap's across all VCC's.
2019-08-21 Removed while: True loops, replaced with for loop to iterate through file. Closed socket before continue in except statement. Commented out rrdtool until it is up on rachel server.
2019-08-26 modify insert.py to run on cron, add script to kill process if exists
